tommy-codex/laser-gun-IoT/3dModel/Base_2_ESP V2.stl

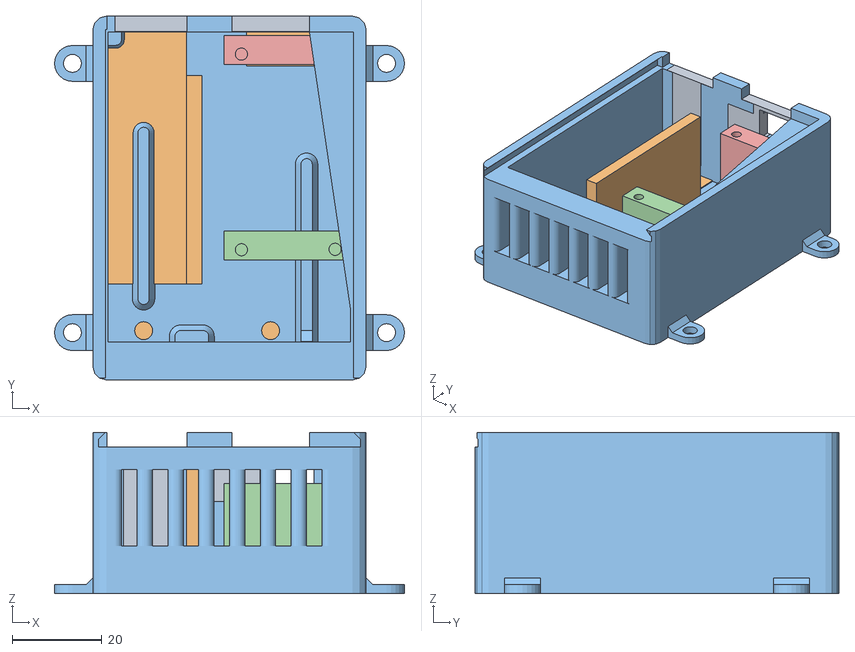
[picture p6: CAD file, 2016-12-04]
3dModel/Base_2_ESP V2.stl
78.0 x 81.1 x 35.9
