tommy-codex/laser-gun-IoT/3dModel/TOP-PIECE-PARTS.stl

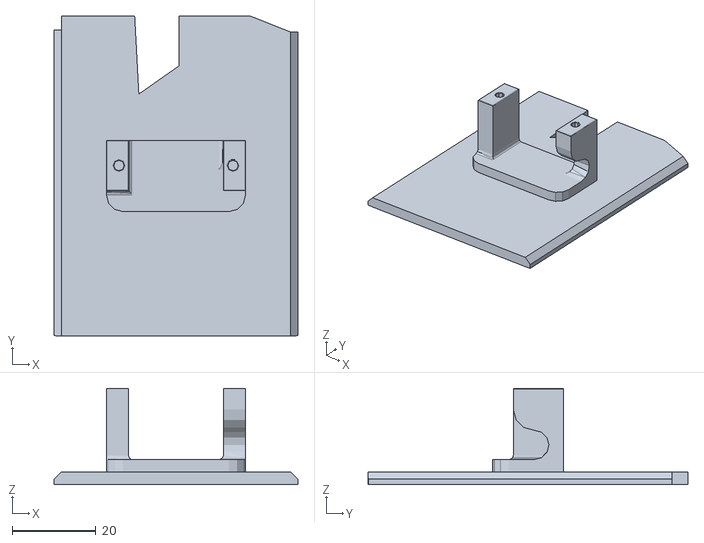
[picture p7: CAD file, 2016-12-04]
3dModel/TOP-PIECE-PARTS.stl
58.2 x 76.3 x 23.0
