tommy-codex/laser-gun-IoT/3dModel/TORCH_GUN_OTHER_PARTS.stl

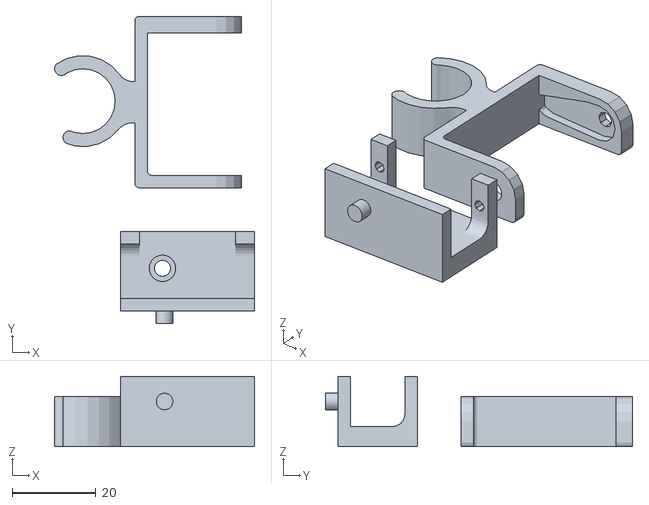
[picture p8: CAD file, 2016-12-04]
3dModel/TORCH_GUN_OTHER_PARTS.stl
47.8 x 73.5 x 16.8
