tommy-codex/laser-gun-IoT/Laser_Gun/I_WebServer.ino

ESP8266WebServer webServer(80);
WebSocketsServer webSocket(81);

// Latest joystick deflection received from the pad (-1..1 each axis).
// The actual servo motion is integrated from this at a fixed tick in
// Z_main.ino's loop(), via ServoLaserMotor::updateJoystick(), so movement
// keeps going for as long as the stick stays pushed rather than jumping to
// a fixed position.
float joyX = 0;
float joyY = 0;

class LaserWebServer{

  public:

  // Expected payloads from the control pad:
  //  {"x":0.42,"y":-0.87}  -> right joystick, aim deflection (normalized -1..1)
  //  {"fire":true|false}   -> left trigger, laser relay
  static void onWebSocketEvent(uint8_t clientId, WStype_t type, uint8_t * payload, size_t length){
    switch(type){
      case WStype_CONNECTED:
        SerialComunication::info("LaserWebServer", "onWebSocketEvent", "Client connected");
        break;

      case WStype_DISCONNECTED:
        SerialComunication::info("LaserWebServer", "onWebSocketEvent", "Client disconnected");
        joyX = 0;
        joyY = 0;
        laserTrigger.set(false);
        break;

      case WStype_TEXT: {
        StaticJsonBuffer<200> jsonBuffer;
        JsonObject& json = jsonBuffer.parseObject((char*)payload);
        if(!json.success()){
          SerialComunication::error("LaserWebServer", "onWebSocketEvent", "Invalid JSON payload");
          break;
        }
        if(json.containsKey("x") && json.containsKey("y")){
          joyX = json["x"];
          joyY = json["y"];
        }
        if(json.containsKey("fire")){
          laserTrigger.set(json["fire"]);
        }
        break;
      }

      default:
        break;
    }
  }

  static void setup(){
    if(!SPIFFS.begin()){
      SerialComunication::error("LaserWebServer", "setup", "Failed to mount SPIFFS");
    }
    webServer.serveStatic("/", SPIFFS, "/");
    webServer.begin();

    webSocket.begin();
    webSocket.onEvent(LaserWebServer::onWebSocketEvent);

    SerialComunication::info("LaserWebServer", "setup", "HTTP server on :80, WebSocket on :81");
  }

  static void loop(){
    webServer.handleClient();
    webSocket.loop();
  }
};
