tommy-codex/laser-gun-IoT/(commit log)

2016-12-08 Added UDP server Example Added MotorTask Class to manage the execution of motor Task Added MQTT Manager Added Config Manager Added WifiManager Manager Renamed file to makeit orded
2026-08-11 Add laser relay trigger and WebSocket control server
    Adds a digital relay output (LaserTrigger, D7) to fire the laser
    remotely, a joystick-to-servo mapping on ServoLaserMotor, and an
    ESP8266WebServer + WebSocket server (I_WebServer) that will serve the
    upcoming web control pad and forward its {x,y}/{fire} messages to the
    motors and relay.
2026-08-11 Add mobile control pad web UI with virtual robot demo mode
    Dual touch-stick pad served by the ESP: the right stick drives aim
    (x/y sent over WebSocket to the servos), the left is a hold-to-fire
    trigger for the laser relay. No external dependencies (no CDN), so it
    still works when the ESP is only reachable as a WiFi access point.
    A Demo mode (default on first load, for safety) skips the WebSocket
    and drives the same canvas robot renderer locally, so the pad can be
    designed/tested without the physical gun powered on.
2026-08-11 Update README for laser relay, web control pad, and new repo home
    Documents the new laser relay wiring (D7) and the ESP-hosted control
    pad setup/upload steps, adds the WebSockets library to the install
    list, and repoints the datasheet/example links from the old
    enricoaleandri/LaserGun-IoT-driver repo to this one. Drops the
    reference to the separate LaserGun-IoT-web repo, since the web UI now
    lives here as WebUI/.
2026-08-11 Replace 2D canvas demo with a CSS 3D pan/tilt robot rig
    Models the real assembly (base servo pans the whole arm, a second
    servo mounted on top tilts the laser tube) as an actual 3D scene built
    from CSS 3D transforms - no WebGL/Three.js, keeping the pad dependency
    free for SPIFFS. Drag the background to orbit the camera around the
    rig.
2026-08-11 Switch aim control from absolute position to rate control on SG90 limits
    Both pan and tilt are plain SG90 servos, so joystick deflection now
    drives them as a speed integrated over time (ServoLaserMotor::
    updateJoystick(), ticked every 20ms from loop()) instead of mapping
    stick position straight to a target angle: holding the stick keeps the
    aim moving, releasing it stops it in place. Travel is clamped to a
    safe 10-170 deg range well inside the 180 deg mechanical limit so the
    gears never stall against the end-stop. The demo robot mirrors the
    same integration so it previews real hardware behavior, and its two
    servos are now modeled as actual SG90s (body + mounting flange + gear
    boss) instead o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
    [B_ServoLaserMotor.ino, I_WebServer.ino, Z_main.ino]
2026-08-11 Fix demo rig so servo bodies stay fixed and only the horns move
    Both servo bodies were nested inside their own rotating joint, so the
    whole servo appeared to spin - not how a real servo works, only the
    horn (and whatever is bolted to it) rotates while the body stays put.
    Restructured so panServo/tiltServo are static, mounted to the case and
    to the bracket respectively, and each joint now only carries the parts
    actually attached to that servo's horn.
2026-08-11 Fix tilt rotating around the laser's own axis instead of pivoting it
    The laser tube is mounted extending along local X, but the tilt joint
    was rotating around X too - that's the tube's own long axis, so it
    just spun in place instead of swinging up/down. Rotate around Z
    instead, which is perpendicular to both the tube and the pan axis.
2026-08-11 Clamp downward tilt so the laser can't swing into the base
    Past ~53 deg below horizontal, the laser tube's far end geometrically
    swings down into the case (confirmed by the demo showing it clip
    through the base). Tilt's downward limit is now 50 deg (absolute servo
    angle) instead of the shared 10 deg pan/tilt floor, with a safety
    margin - pan is unaffected since it only spins the bracket around its
    own vertical axis. Applied to both the demo rig and the real firmware
    clamp in ServoLaserMotor::updateJoystick(), since the physical arm
    would hit the case/bracket the same way on real hardware.
2026-08-11 Invert pan direction to match stick left/right
    Pushing the aim stick right was panning left and vice versa. Flipped
    the sign of the X contribution in both the demo rig and
    ServoLaserMotor::updateJoystick() so they stay consistent with each
    other.
    [B_ServoLaserMotor.ino]
2026-08-11 Fix pre-existing build error: ambiguous String(IPAddress)
    WiFi.localIP() wrapped in String(...) fails to compile on current
    ESP8266 core versions (multiple ambiguous String constructors match
    IPAddress's implicit conversions). Found while actually compiling the
    sketch end-to-end with arduino-cli to verify the new relay/websocket/
    servo code builds - this line predates that work and was blocking the
    whole sketch from building regardless. IPAddress::toString() is the
    unambiguous way to get the same string.
    [F_WifiManaged.ino]
